designerGenes/cyclops/hardware/luckfox-pico-pro/SUPERSEDED.md

# SUPERSEDED — v0 "top-hood" enclosure

The `luckfox_enclosure_*` design generated by `enclosure_geometry.py` +
`generate_case.py` (and its `out/stl/` outputs) is **superseded**.

**Superseded by:** [`v1_1/src/luckfox_pill_enclosure.py`](v1_1/src/luckfox_pill_enclosure.py)
— the "fat pill" wall-camera enclosure, generator version 1.1. Read `v1_1/DESIGN.md`.

## What this directory now holds

| Path | Contents |
|---|---|
| `v0_superseded/` | The five pristine v0 STLs (`luckfox_enclosure_{base,cover,hood,gasket,thermal_seal}.stl`). Archived, never deleted. |
| `v1_1/` | The complete v1.1 set: `DESIGN.md`, `src/`, `stl/` (ASCII), `print/` (binary), `preview/`. |
| `enclosure_geometry.py`, `generate_case.py`, `generate.sh`, `tests/` | The v0 generator, **left in place, unedited**. |

## Why v0 was retired

Per `v1_1/DESIGN.md`: base and cover met in a flat butt joint with no screws,
clips, lip or overlap, so nothing held them together; the gasket groove left
0.2 mm side walls and bridged an open port; the hood pins did not retain; the
hood plate sat 8 mm in front of the camera aperture and blocked the field of
view; and there were no standoffs, camera mount or wall-mount features. The
replacement uses a screw closure, an O-ring cord seal, a printed board sled and
a wall bracket.

## Not to be confused with

- `print-submission/` — the earlier first-article print bundle for the **v0**
  design; it does not reflect v1.1.
- `out/` — v0 build artifacts; regenerate only if you intentionally revisit v0.
