designerGenes/cyclops/hardware/luckfox-pico-pro/out/preview/luckfox_enclosure_front.png

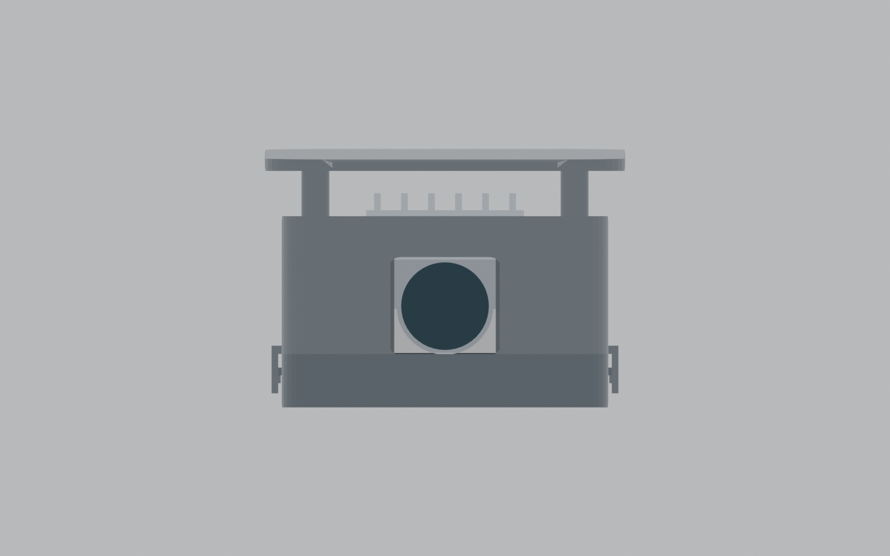
hardware/luckfox-pico-pro/out/preview/luckfox_enclosure_front.png
