designerGenes/cyclops/hardware/luckfox-pico-pro/out/preview/luckfox_enclosure_iso.png

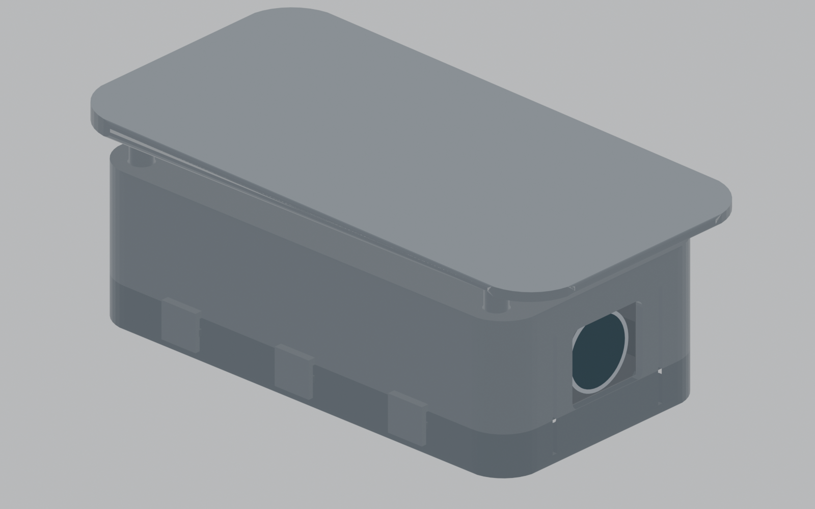
hardware/luckfox-pico-pro/out/preview/luckfox_enclosure_iso.png
