designerGenes/cyclops/hardware/luckfox-pico-pro/out/preview/luckfox_enclosure_rear.png

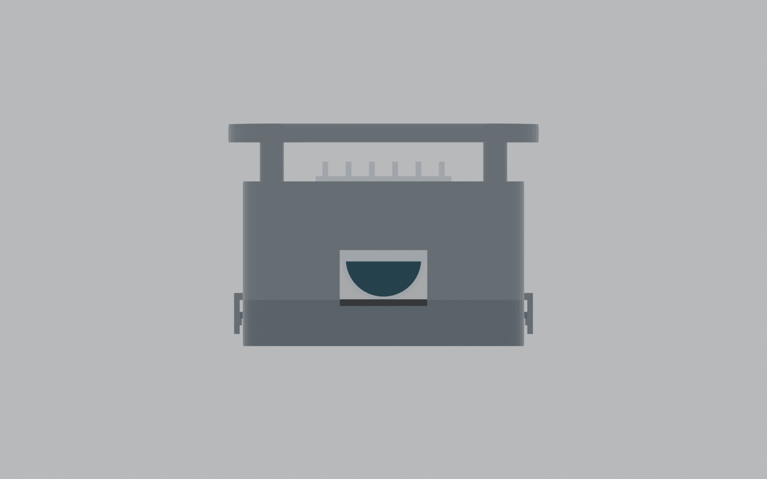
hardware/luckfox-pico-pro/out/preview/luckfox_enclosure_rear.png
