designerGenes/cyclops/hardware/luckfox-pico-pro/out/preview/luckfox_enclosure_side.png

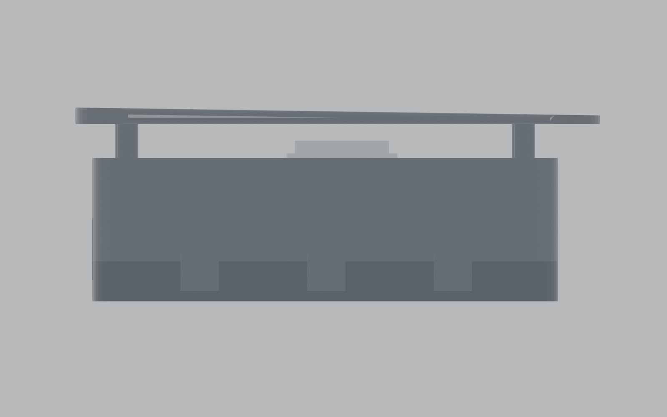
hardware/luckfox-pico-pro/out/preview/luckfox_enclosure_side.png
