designerGenes/cyclops/hardware/luckfox-pico-pro/out/preview/luckfox_enclosure_top.png

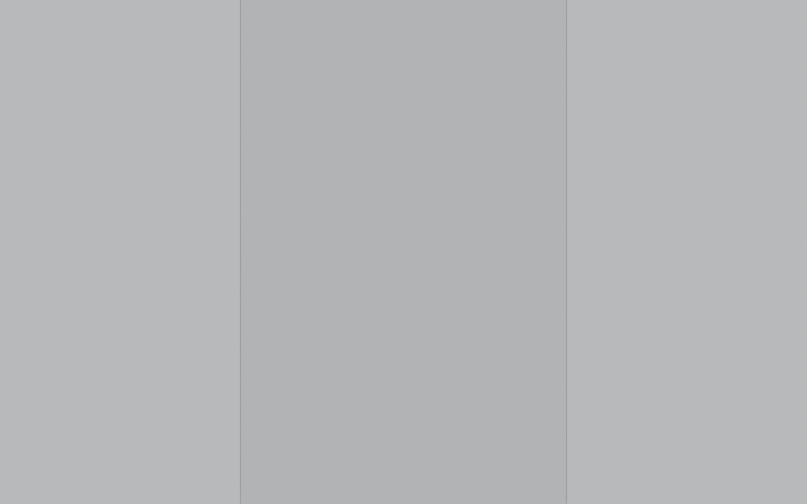
hardware/luckfox-pico-pro/out/preview/luckfox_enclosure_top.png
