designerGenes/cyclops/hardware/luckfox-pico-pro/v1_1/preview/assembly_preview_DO_NOT_PRINT.stl

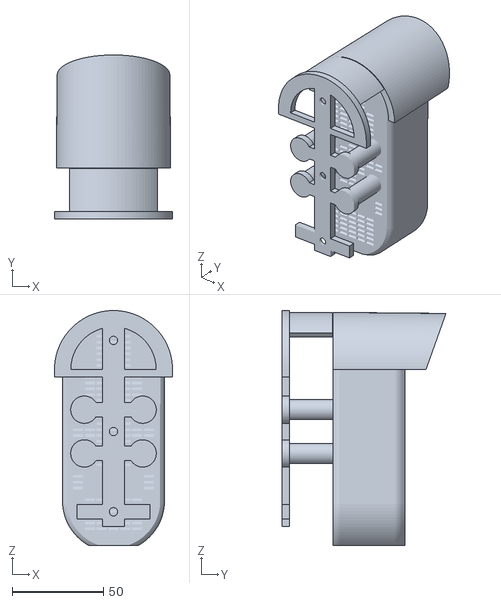
[picture p9: CAD file, 2026-10-25]
hardware/luckfox-pico-pro/v1_1/preview/assembly_preview_DO_NOT_PRINT.stl
64.8 x 90.0 x 128.9
