designerGenes/cyclops/hardware/luckfox-pico-pro/out/stl/luckfox_enclosure_thermal_seal.stl

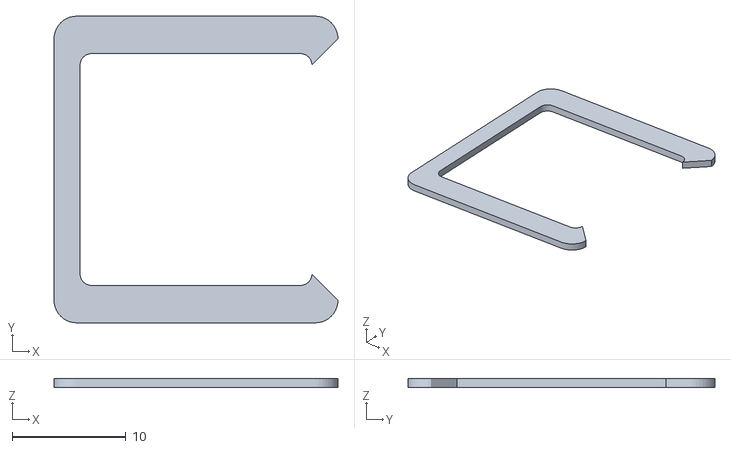
[picture p10: CAD file, 2026-10-25]
hardware/luckfox-pico-pro/out/stl/luckfox_enclosure_thermal_seal.stl
25.0 x 27.0 x 0.8
