designerGenes/cyclops/hardware/luckfox-pico-pro/v1_1/preview/board_sled.stl

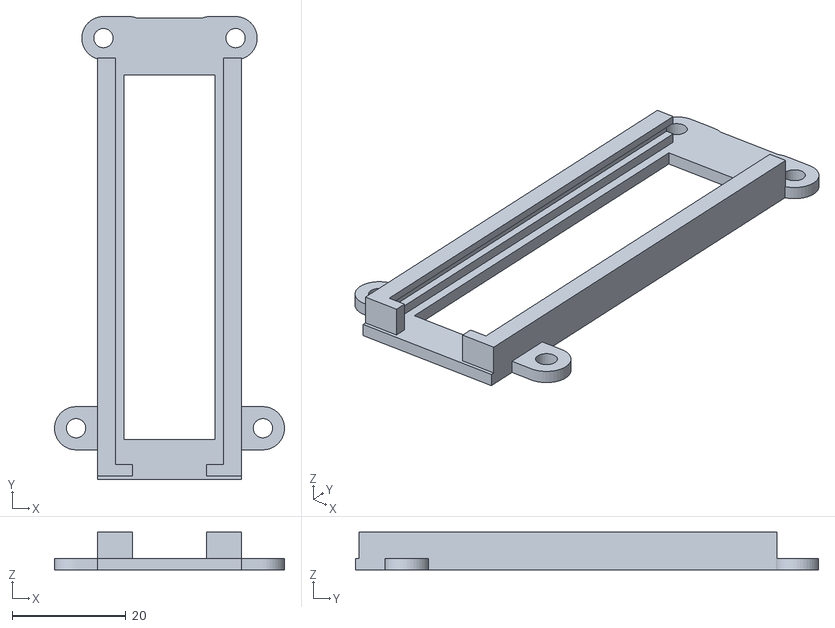
[picture p11: CAD file, 2026-10-25]
hardware/luckfox-pico-pro/v1_1/preview/board_sled.stl
40.4 x 81.3 x 6.60
