designerGenes/cyclops/hardware/luckfox-pico-pro/v1_1/print/wall_bracket.stl

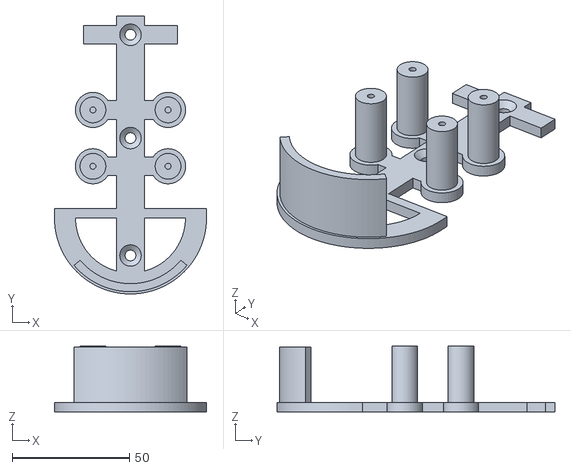
[picture p12: CAD file, 2026-10-25]
hardware/luckfox-pico-pro/v1_1/print/wall_bracket.stl
64.8 x 118.4 x 28.0
