designerGenes/cyclops/hardware/luckfox-pico-pro/out/stl/luckfox_enclosure_base.stl

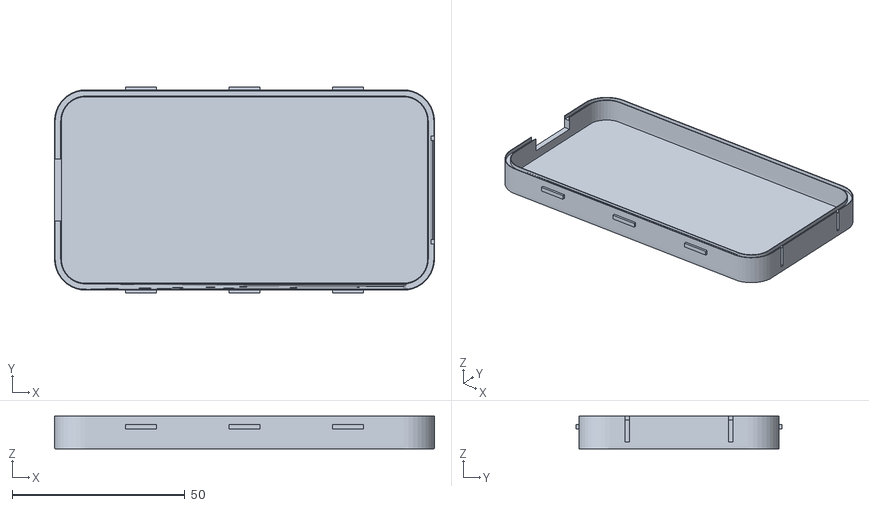
[picture p13: CAD file, 2026-10-25]
hardware/luckfox-pico-pro/out/stl/luckfox_enclosure_base.stl
110.0 x 59.6 x 9.50
