designerGenes/cyclops/hardware/luckfox-pico-pro/v1_1/preview/camera_clamp.stl

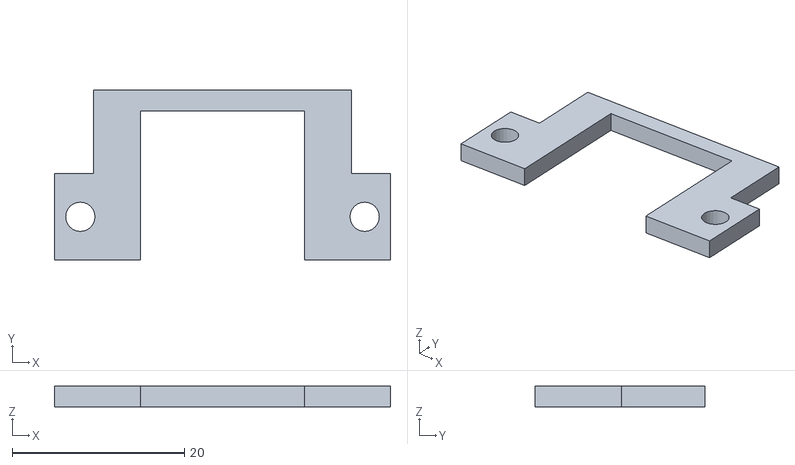
[picture p14: CAD file, 2026-10-25]
hardware/luckfox-pico-pro/v1_1/preview/camera_clamp.stl
39.0 x 19.7 x 2.40
