designerGenes/cyclops/hardware/luckfox-pico-pro/v1_1/print/pill_body.stl

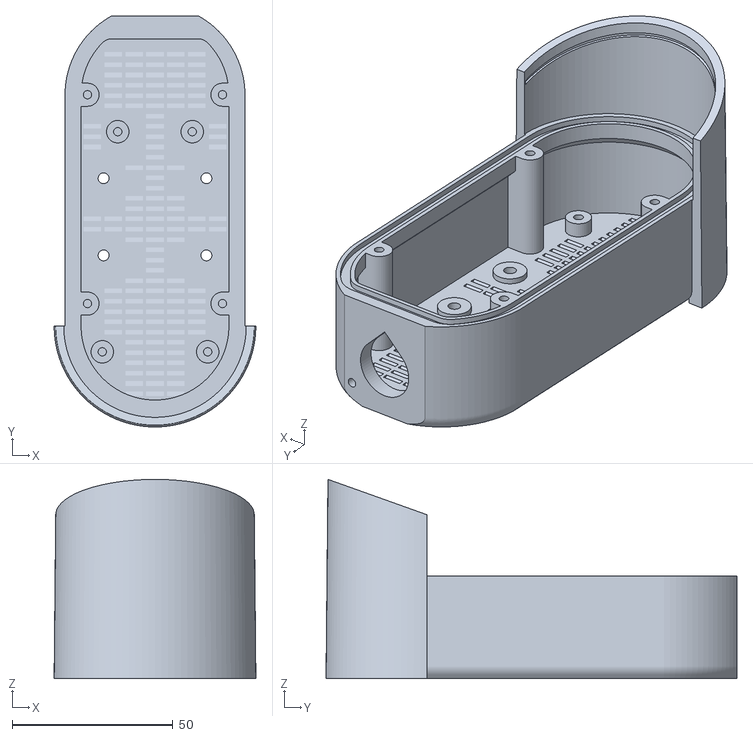
[picture p15: CAD file, 2026-10-25]
hardware/luckfox-pico-pro/v1_1/print/pill_body.stl
62.8 x 127.9 x 62.0
