designerGenes/cyclops/hardware/luckfox-pico-pro/out/stl/luckfox_enclosure_gasket.stl

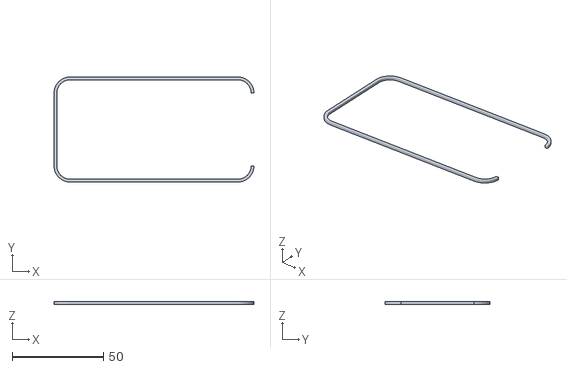
[picture p16: CAD file, 2026-10-25]
hardware/luckfox-pico-pro/out/stl/luckfox_enclosure_gasket.stl
109.6 x 57.6 x 1.40
