designerGenes/cyclops/hardware/luckfox-pico-pro/v1_1/print/pill_cover.stl

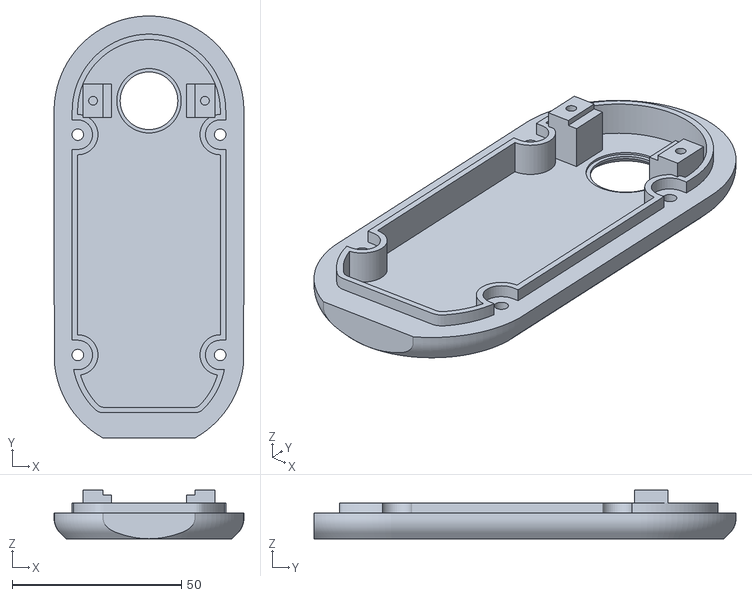
[picture p17: CAD file, 2026-10-25]
hardware/luckfox-pico-pro/v1_1/print/pill_cover.stl
56.0 x 124.5 x 14.4
