designerGenes/cyclops/hardware/luckfox-pico-pro/out/stl/luckfox_enclosure_cover.stl

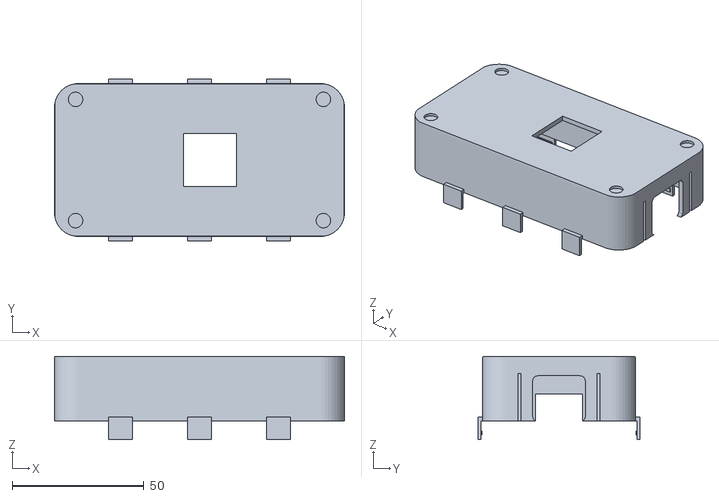
[picture p18: CAD file, 2026-10-25]
hardware/luckfox-pico-pro/out/stl/luckfox_enclosure_cover.stl
110.0 x 61.6 x 31.5
