designerGenes/cyclops/hardware/luckfox-pico-pro/out/stl/luckfox_enclosure_thermal_insert.stl

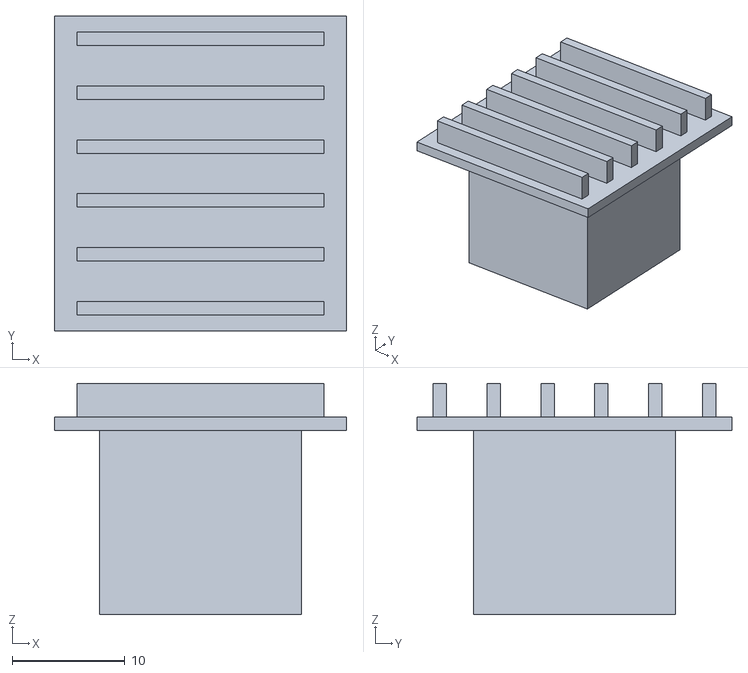
[picture p19: CAD file, 2026-10-04]
hardware/luckfox-pico-pro/out/stl/luckfox_enclosure_thermal_insert.stl
26.0 x 28.0 x 20.5
