designerGenes/cyclops/hardware/luckfox-pico-pro/out/stl/luckfox_enclosure_hood.stl

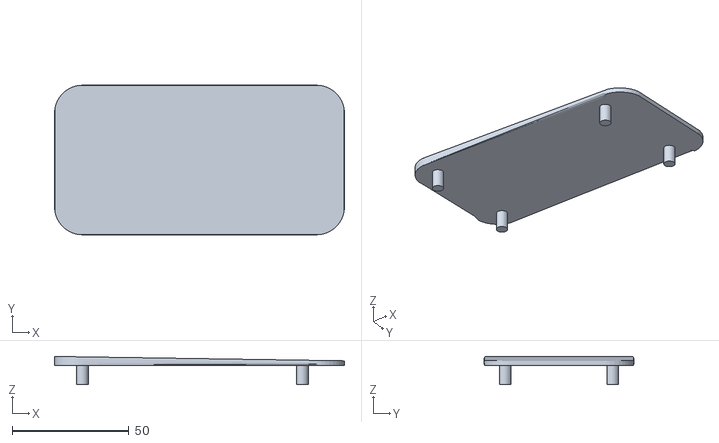
[picture p20: CAD file, 2026-10-04]
hardware/luckfox-pico-pro/out/stl/luckfox_enclosure_hood.stl
124.0 x 64.0 x 12.0
