designerGenes/cyclops/hardware/luckfox-pico-pro/out/stl/luckfox_enclosure_chimney.stl

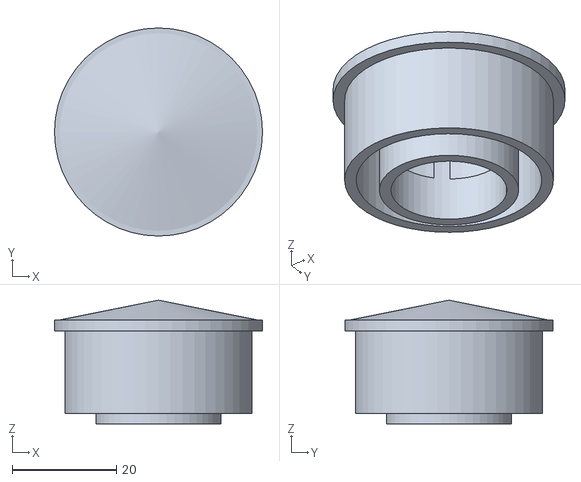
[picture p21: CAD file, 2026-10-03]
hardware/luckfox-pico-pro/out/stl/luckfox_enclosure_chimney.stl
40.0 x 40.0 x 23.8
