designerGenes/cyclops/hardware/luckfox-pico-pro/out/stl/luckfox_enclosure_nose.stl

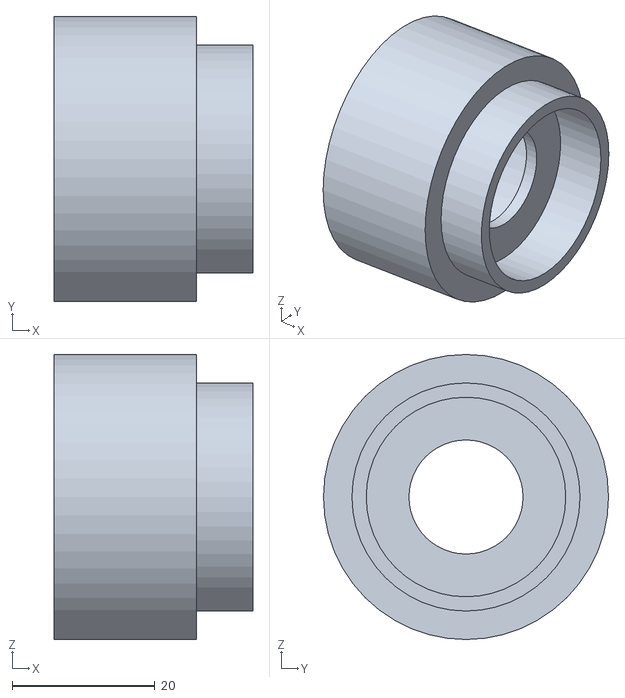
[picture p22: CAD file, 2026-10-03]
hardware/luckfox-pico-pro/out/stl/luckfox_enclosure_nose.stl
27.9 x 40.0 x 40.0
