designerGenes/cyclops/hardware/luckfox-pico-pro/v0_superseded/luckfox_enclosure_base.stl

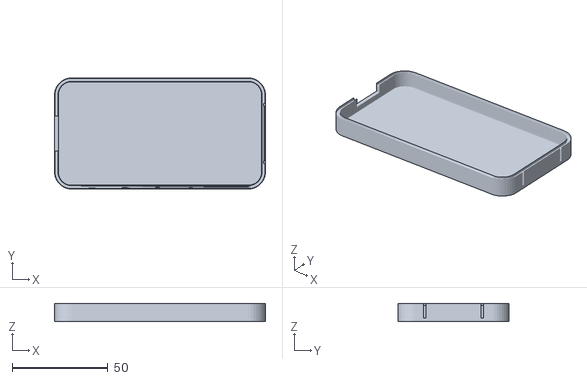
[picture p23: CAD file, 2026-10-25, an earlier design]
hardware/luckfox-pico-pro/v0_superseded/luckfox_enclosure_base.stl
110.0 x 58.0 x 9.50
