designerGenes/cyclops/(list of files, cad)

Other CAD files:
hardware/luckfox-pico-pro/print-submission/luckfox_enclosure_thermal_seal.stl
hardware/luckfox-pico-pro/v1_1/stl/board_sled.stl
hardware/luckfox-pico-pro/v1_1/stl/camera_clamp.stl
hardware/luckfox-pico-pro/out/luckfox_pico_pro_enclosure.blend
hardware/luckfox-pico-pro/v1_1/stl/pill_body.stl
hardware/luckfox-pico-pro/v1_1/stl/pill_cover.stl
hardware/luckfox-pico-pro/v1_1/stl/wall_bracket.stl
