designerGenes/cyclops/docs/testing/test-plan.md

# Test Plan

Cyclops Phase 1 verification requires all of the following. Run each command from the repository root.

## Python backend tests

```bash
uv run pytest apps/edge-camera/tests apps/coordinator-api/tests
```

Coverage includes edge MJPEG behavior, settings page/API, health reporting, coordinator registry loading, layout persistence, health polling, and stale layout reconciliation.

## Frontend unit tests

```bash
pnpm test
```

Coverage includes rendering 1/2/3/4/N camera layouts, offline tiles, reorder and resize state, localStorage persistence, and stale layout cleanup.

## Mobile end-to-end tests

```bash
pnpm --filter coordinator-web exec playwright test
```

The Playwright suite runs with a mobile viewport, verifies the stacked layout, tests tile reorder and resize behavior, confirms reload persistence, and ensures offline tiles remain visible.
