designerGenes/cyclops/firmware/luckfox-pico-pro/src/osd.c

/* On-device timestamp OSD for the Luckfox Cyclops eye.
 *
 * Draws "YYYY-MM-DD HH:MM:SS" into an ARGB8888 bitmap and overlays it on the
 * hardware H.264 encoder output via the Rockchip RGN module, so the timestamp
 * is burned into the stream (matching the Pi eyes' rpiCameraTextOverlay).
 *
 * The viewer applies a per-node display rotation (0/90/180/270 clockwise). To
 * keep the timestamp upright and in the top-left of what the viewer sees, the
 * text is rendered counter-rotated and attached to the corner of the sensor
 * frame that maps to the displayed top-left.
 *
 * Color: one of a few high-legibility presets (white/yellow/black/red), each
 * drawn with a contrasting outline (black under bright fills, white under the
 * black fill) so the digits stay crisp on any scene. The console advances the
 * preset on click; there is no automatic animation.
 * Size: an integer cell scale (3..12) controls the glyph size.
 */

#include "cyclops_eye/osd.h"

#include <pthread.h>
#include <stdatomic.h>
#include <stdbool.h>
#include <stdint.h>
#include <stdlib.h>
#include <string.h>
#include <time.h>
#include <unistd.h>

#include "rk_mpi_rgn.h"
#include "rk_common.h"

#define OSD_CHARS 19
#define OSD_OUTLINE_PX 2 /* outline thickness around the glyphs, in pixels */
#define OSD_RGN_HANDLE 0
#define OSD_MARGIN 16

/* The RV1106 rockit RGN overlay reads each ARGB8888 pixel as A(byte0),
 * R(byte1), G(byte2), B(byte3) in memory - i.e. the 32-bit value is
 * 0xBBGGRRAA with alpha in the LOW byte. Verified on hardware: packing as
 * 0xAARRGGBB put alpha in the ignored high byte, so any color whose low byte
 * was 0x00 vanished and channel order was wrong. OSD_RGB packs correctly. */
#define OSD_RGB(r, g, b) (((uint32_t)(b) << 24) | ((uint32_t)(g) << 16) | \
                          ((uint32_t)(r) << 8) | 0xFFu)

/* Legibility-first fill/outline pairs, indexed by the EYE_OSD_* presets. */
static const uint32_t OSD_FILL[EYE_OSD_COLOR_MAX + 1] = {
    OSD_RGB(0xFF, 0xFF, 0xFF), /* WHITE  */
    OSD_RGB(0xFF, 0xE4, 0x00), /* YELLOW */
    OSD_RGB(0x1A, 0x1A, 0x1A), /* BLACK  */
    OSD_RGB(0xFF, 0x3B, 0x30), /* RED    */
};
static const uint32_t OSD_OUTLINE[EYE_OSD_COLOR_MAX + 1] = {
    OSD_RGB(0x00, 0x00, 0x00), /* black outline for white */
    OSD_RGB(0x00, 0x00, 0x00), /* black outline for yellow */
    OSD_RGB(0xFF, 0xFF, 0xFF), /* white outline for black */
    OSD_RGB(0x00, 0x00, 0x00), /* black outline for red */
};

/* Each row is 3 bits, bit0 = leftmost column. */
static const unsigned char FONT3X5[13][5] = {
    {7, 5, 5, 5, 7}, /* 0 */
    {2, 6, 2, 2, 7}, /* 1 */
    {7, 1, 7, 4, 7}, /* 2 */
    {7, 1, 7, 1, 7}, /* 3 */
    {5, 5, 7, 1, 1}, /* 4 */
    {7, 4, 7, 1, 7}, /* 5 */
    {7, 4, 7, 5, 7}, /* 6 */
    {7, 1, 1, 1, 1}, /* 7 */
    {7, 5, 7, 5, 7}, /* 8 */
    {7, 5, 7, 1, 7}, /* 9 */
    {0, 0, 7, 0, 0}, /* - */
    {0, 2, 0, 2, 0}, /* : */
    {0, 0, 0, 0, 0}, /* space (anything else) */
};

static int glyph_index(char c) {
    if (c >= '0' && c <= '9') return c - '0';
    if (c == '-') return 10;
    if (c == ':') return 11;
    return 12;
}

struct eye_osd {
    RGN_HANDLE handle;
    int venc_channel;
    int frame_w;
    int frame_h;
    int rotation;   /* 0/90/180/270 clockwise, as the viewer rotates */
    int scale;      /* glyph cell size in pixels */
    int color;      /* EYE_OSD_* preset */
    int text_w;     /* rendered text bitmap size */
    int text_h;
    int dst_w;      /* rendered bitmap size after counter-rotation */
    int dst_h;
    uint32_t *text; /* horizontal text, text_w x text_h */
    uint32_t *buf;  /* counter-rotated bitmap attached to the VENC */
    pthread_t thread;
    atomic_bool running;
    atomic_bool update_pending; /* set by eye_osd_set_color to force a refresh */
    bool started;
};

/* Paint a solid block into `buf`, clamped to [0,text_w) x [0,text_h). */
static void paint_block(eye_osd_t *o, int x, int y, int w, int h, uint32_t color) {
    if (x < 0) { w += x; x = 0; }
    if (y < 0) { h += y; y = 0; }
    if (x + w > o->text_w) w = o->text_w - x;
    if (y + h > o->text_h) h = o->text_h - y;
    if (w <= 0 || h <= 0) return;
    for (int dy = 0; dy < h; dy++) {
        uint32_t *line = o->text + (size_t)(y + dy) * o->text_w + x;
        for (int dx = 0; dx < w; dx++) line[dx] = color;
    }
}

static uint32_t osd_fill_color(const eye_osd_t *o) {
    return OSD_FILL[o->color];
}

static void render_text(eye_osd_t *o, const char *s, uint32_t fill, uint32_t outline) {
    memset(o->text, 0, (size_t)o->text_w * o->text_h * sizeof(uint32_t));
    int scale = o->scale;
    int x0 = 0;
    /* Pass 1: draw the outline (a dilation of the glyph) for every lit cell
     * first, so adjacent cells merge into one contiguous border instead of
     * black streaks cutting through the fill. */
    for (int i = 0; s[i] != '\0' && i < OSD_CHARS; i++, x0 += 4 * scale) {
        int gi = glyph_index(s[i]);
        for (int row = 0; row < 5; row++) {
            unsigned bits = FONT3X5[gi][row];
            for (int col = 0; col < 3; col++) {
                if (!((bits >> col) & 1u)) continue;
                /* Glyph table encodes bit0 as the RIGHTMOST column, so reverse
                 * the column order here. */
                int px = x0 + (2 - col) * scale;
                int py = row * scale;
                paint_block(o, px - OSD_OUTLINE_PX, py - OSD_OUTLINE_PX,
                            scale + 2 * OSD_OUTLINE_PX, scale + 2 * OSD_OUTLINE_PX, outline);
            }
        }
    }
    /* Pass 2: the colored fill, painted last so it is never overwritten. */
    x0 = 0;
    for (int i = 0; s[i] != '\0' && i < OSD_CHARS; i++, x0 += 4 * scale) {
        int gi = glyph_index(s[i]);
        for (int row = 0; row < 5; row++) {
            unsigned bits = FONT3X5[gi][row];
            for (int col = 0; col < 3; col++) {
                if (!((bits >> col) & 1u)) continue;
                int px = x0 + (2 - col) * scale;
                int py = row * scale;
                paint_block(o, px, py, scale, scale, fill);
            }
        }
    }
}

/* Rotate src (sw x sh) clockwise by deg (0/90/180/270) into dst, returning the
 * output dimensions. */
static void rotate_cw(const uint32_t *src, int sw, int sh,
                      uint32_t *dst, int deg, int *dw, int *dh) {
    if (deg == 90 || deg == 270) { *dw = sh; *dh = sw; }
    else { *dw = sw; *dh = sh; }
    for (int y = 0; y < *dh; y++) {
        for (int x = 0; x < *dw; x++) {
            int sx, sy;
            if (deg == 90)       { sx = y;          sy = sh - 1 - x; }
            else if (deg == 180) { sx = sw - 1 - x; sy = sh - 1 - y; }
            else if (deg == 270) { sx = sw - 1 - y; sy = x; }
            else                 { sx = x;          sy = y; }
            dst[(size_t)y * (*dw) + x] = src[(size_t)sy * sw + sx];
        }
    }
}

static void osd_render(eye_osd_t *o, const char *s) {
    render_text(o, s, osd_fill_color(o), OSD_OUTLINE[o->color]);
    /* Counter-rotate the text by the viewer's rotation. */
    int deg = (360 - o->rotation) % 360;
    rotate_cw(o->text, o->text_w, o->text_h, o->buf, deg, &o->dst_w, &o->dst_h);
}

static void osd_position(const eye_osd_t *o, int *x, int *y) {
    switch (o->rotation) {
    case 90:
        *x = OSD_MARGIN;
        *y = o->frame_h - o->dst_h - OSD_MARGIN;
        break;
    case 180:
        *x = o->frame_w - o->dst_w - OSD_MARGIN;
        *y = o->frame_h - o->dst_h - OSD_MARGIN;
        break;
    case 270:
        *x = o->frame_w - o->dst_w - OSD_MARGIN;
        *y = OSD_MARGIN;
        break;
    default:
        *x = OSD_MARGIN;
        *y = OSD_MARGIN;
        break;
    }
}

static void osd_chn(MPP_CHN_S *chn, int venc_channel) {
    memset(chn, 0, sizeof(*chn));
    chn->enModId = RK_ID_VENC;
    chn->s32DevId = 0;
    chn->s32ChnId = venc_channel;
}

static void osd_push(eye_osd_t *o) {
    BITMAP_S bmp;
    memset(&bmp, 0, sizeof(bmp));
    bmp.enPixelFormat = RK_FMT_ARGB8888;
    bmp.u32Width = (RK_U32)o->dst_w;
    bmp.u32Height = (RK_U32)o->dst_h;
    bmp.pData = o->buf;
    (void)RK_MPI_RGN_SetBitMap(o->handle, &bmp);
}

static void *osd_thread(void *arg) {
    eye_osd_t *o = arg;
    time_t last = 0;
    while (atomic_load(&o->running)) {
        time_t now = time(NULL);
        bool forced = atomic_exchange(&o->update_pending, false);
        if (!forced && now == last) {
            usleep(100000); /* 100ms wake; re-render on the next second or update */
            continue;
        }
        last = now;
        struct tm tm;
        localtime_r(&now, &tm);
        char s[32];
        if (strftime(s, sizeof(s), "%Y-%m-%d %H:%M:%S", &tm) > 0) {
            osd_render(o, s);
            osd_push(o);
        }
    }
    return NULL;
}

static int osd_attach(eye_osd_t *o) {
    RGN_ATTR_S attr;
    memset(&attr, 0, sizeof(attr));
    attr.enType = OVERLAY_RGN;
    attr.unAttr.stOverlay.enPixelFmt = RK_FMT_ARGB8888;
    attr.unAttr.stOverlay.stSize.u32Width = (RK_U32)o->dst_w;
    attr.unAttr.stOverlay.stSize.u32Height = (RK_U32)o->dst_h;
    attr.unAttr.stOverlay.u32CanvasNum = 2;
    if (RK_MPI_RGN_Create(o->handle, &attr) != RK_SUCCESS) return -1;
    osd_push(o);

    MPP_CHN_S chn;
    osd_chn(&chn, o->venc_channel);
    int x, y;
    osd_position(o, &x, &y);
    RGN_CHN_ATTR_S ca;
    memset(&ca, 0, sizeof(ca));
    ca.bShow = RK_TRUE;
    ca.enType = OVERLAY_RGN;
    ca.unChnAttr.stOverlayChn.stPoint.s32X = x;
    ca.unChnAttr.stOverlayChn.stPoint.s32Y = y;
    ca.unChnAttr.stOverlayChn.u32FgAlpha = 255;
    ca.unChnAttr.stOverlayChn.u32BgAlpha = 0;
    ca.unChnAttr.stOverlayChn.u32Layer = 0;
    if (RK_MPI_RGN_AttachToChn(o->handle, &chn, &ca) != RK_SUCCESS) {
        (void)RK_MPI_RGN_Destroy(o->handle);
        return -1;
    }
    return 0;
}

eye_osd_t *eye_osd_start(int venc_channel, int frame_w, int frame_h,
                         int rotation, int scale, int color) {
    eye_osd_t *o = calloc(1, sizeof(*o));
    if (o == NULL) return NULL;
    atomic_store(&o->update_pending, false);
    o->venc_channel = venc_channel;
    o->frame_w = frame_w;
    o->frame_h = frame_h;
    rotation = ((rotation % 360) + 360) % 360;
    o->rotation = (rotation / 90) * 90;   /* snap to 0/90/180/270 */
    if (scale < 3) scale = 3;
    if (scale > 12) scale = 12;
    o->scale = scale;
    if (color < EYE_OSD_WHITE) color = EYE_OSD_WHITE;
    if (color > EYE_OSD_COLOR_MAX) color = EYE_OSD_COLOR_MAX;
    o->color = color;
    o->text_w = ((OSD_CHARS * 4 * scale) + 15) / 16 * 16;   /* align 16 */
    o->text_h = ((5 * scale) + 15) / 16 * 16;               /* align 16 */
    o->handle = OSD_RGN_HANDLE;
    o->text = calloc((size_t)o->text_w * o->text_h, sizeof(uint32_t));
    o->buf = calloc((size_t)o->text_w * o->text_h, sizeof(uint32_t));
    if (o->text == NULL || o->buf == NULL) {
        free(o->text); free(o->buf); free(o);
        return NULL;
    }
    osd_render(o, "0000-00-00 00:00:00");
    if (osd_attach(o) != 0) {
        free(o->text); free(o->buf); free(o);
        return NULL;
    }

    atomic_store(&o->running, true);
    if (pthread_create(&o->thread, NULL, osd_thread, o) != 0) {
        atomic_store(&o->running, false);
        MPP_CHN_S chn;
        osd_chn(&chn, o->venc_channel);
        (void)RK_MPI_RGN_DetachFromChn(o->handle, &chn);
        (void)RK_MPI_RGN_Destroy(o->handle);
        free(o->text); free(o->buf); free(o);
        return NULL;
    }
    o->started = true;
    return o;
}

void eye_osd_set_color(eye_osd_t *o, int color) {
    if (o == NULL) return;
    if (color < EYE_OSD_WHITE) color = EYE_OSD_WHITE;
    if (color > EYE_OSD_COLOR_MAX) color = EYE_OSD_COLOR_MAX;
    if (color == o->color) return;
    o->color = color;
    atomic_store(&o->update_pending, true);
}

void eye_osd_stop(eye_osd_t *o) {
    if (o == NULL) return;
    if (o->started) {
        atomic_store(&o->running, false);
        (void)pthread_join(o->thread, NULL);
    }
    MPP_CHN_S chn;
    osd_chn(&chn, o->venc_channel);
    (void)RK_MPI_RGN_DetachFromChn(o->handle, &chn);
    (void)RK_MPI_RGN_Destroy(o->handle);
    free(o->text);
    free(o->buf);
    free(o);
}
