designerGenes/cyclops/deployed/eyes/camera-01/boot-firmware/config.txt

# For more options and information see
# http://rptl.io/configtxt
# Some settings may impact device functionality. See link above for details

# Uncomment some or all of these to enable the optional hardware interfaces
dtparam=i2c_arm=on
#dtparam=i2s=on
#dtparam=spi=on

# Enable audio (loads snd_bcm2835)
dtparam=audio=on

# Additional overlays and parameters are documented
# /boot/firmware/overlays/README

# Automatically load overlays for detected cameras
camera_auto_detect=1
dtoverlay=imx708
start_x=1
gpu_mem=128

# Automatically load overlays for detected DSI displays
display_auto_detect=1

# Automatically load initramfs files, if found
auto_initramfs=1

# Enable DRM VC4 V3D driver
dtoverlay=vc4-kms-v3d
max_framebuffers=2

# Don't have the firmware create an initial video= setting in cmdline.txt.
# Use the kernel's default instead.
disable_fw_kms_setup=1

# Run in 64-bit mode
arm_64bit=1

# Disable compensation for displays with overscan
disable_overscan=1

# Run as fast as firmware / board allows
arm_boost=1

start_x=1
gpu_mem=128

[cm4]
# Enable host mode on the 2711 built-in XHCI USB controller.
# This line should be removed if the legacy DWC2 controller is required
# (e.g. for USB device mode) or if USB support is not required.
otg_mode=1

[cm5]
dtoverlay=dwc2,dr_mode=host

[all]

# ---- BEGIN under-clock block ----
arm_freq=800
arm_freq_min=400
core_freq=300
gpu_freq=300
over_voltage=-2
force_turbo=0
# ----  END under-clock block  ----

# Performance tuning settings
arm_freq=800
core_freq=250
sdram_freq=400
over_voltage=-2

# Thermal throttling soft/hard limits (in deg C)
temp_soft_limit=60
temp_limit=70

# Force throttling instead of shutdown
avoid_warnings=1
dtparam=watchdog=on
dtoverlay=disable-bt
