designerGenes/cyclops/(commit log)

2026-08-29 Snapshot deployed Cyclops system (coordinator brain + camera-01/camera-02 eyes)
    Exact copies of the running software captured 2026-08-28 after the
    camnode tier-drift fix. Includes brain /opt/cyclops source, central
    mediamtx config, systemd units, eye camnode agent, node configs, and
    per-eye boot firmware. Enrollment token redacted; venvs, binaries,
    model weights, logs, and alert images excluded. See deployed/README.md.
2026-08-29 Governor clamp: manual tier/fps overrides can no longer exceed thermal budget
    Both eyes overheated again after tier/fps overrides were set from the
    stream UI (camera-01 pinned at warm, camera-02 boosted to 12fps on a
    critical node). The governor now: always runs thermal logic even under
    override; an override can only make the camera run cooler than the
    thermal policy requires; fps boosts are suspended automatically at
    hot/critical. Heartbeat/health now report the effective tier.
2026-08-29 Software heat reductions: LAN-direct RTSP, detect 4fps cap, MoQ off, thermal SMS alert
    Eyes were burning 27-40% CPU in tailscaled encrypting the brain's RTSP
    pull, plus wasted MJPEG frames. Changes:
    - camnode agent reports its LAN IPv4 (register + heartbeat)
    - brain registry stores lan_host; RTSP endpoints prefer the LAN route,
    switching proxy + detect watcher when learned; tailnet fallback after
    3 failed readiness checks, LAN retry every 10 min
    - detect stream capped at 4 fps (brain samples at 4; the rest was heat)
    - mediamtx.yml.j2 + node ymls: moq off, cdn_fast, tier-realistic params
    - brain thermal watchdog: SMS via existing Twilio channel when a node
    holds critical tier for 10+ mi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
2026-10-03 Add LuckFox Pico Pro Eye firmware
2026-10-03 Add weatherproof LuckFox Pico Pro enclosure (passive chimney, Blender parametric)
2026-10-03 Round the LuckFox enclosure: capsule body, round chimney, lens barrel, beveled edges
2026-10-04 Redesign LuckFox enclosure with recessed optics and top hood
2026-10-05 Luckfox RV1106 eye: real camera path, SDK integration, and runbook
    Firmware:
    - initialize Rockchip AIQ/ISP before VI/VENC; use /oem/usr/share/iqfiles
    - redesign: single camera owner via RkLunch.sh (cyclops-eye, rkipc fallback)
    - re-discover the LAN IP every heartbeat (this board's DHCP address changes
    per boot) so the coordinator keeps a working LAN RTSP route
    SDK integration (firmware/luckfox-pico-pro/sdk-integration):
    - app-Makefile: cross-compile cyclops-eye against media libs
    - RkLunch.sh: robust camera-owner launcher
    - make-image.sh / provision-eye.sh / RUNBOOK.md / watch-build.sh
    Validated end-to-end on a Pico Pro/Max: cyclops-eye auto-starts, serves
    /cam (H.264 1920x1080) and /det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
2026-10-06 hardware(luckfox): bundle first-article print service print submission
    - Add hardware/luckfox-pico-pro/print-submission/: one enclosure set
    (base, cover, hood, gasket, thermal_seal) with README covering part
    list, ABS-only material caveats, and cost estimate for the City of
    print service Library 3D printing service.
    - Remove obsolete chimney/nose STLs (no longer emitted by the generator).
    - Point the hardware README at the submission bundle.
2026-10-09 firmware(luckfox): harden camera-owner lifecycle against librkaiq teardown crash
    Root cause: cyclops-eye SIGSEGVs inside librkaiq.so (rk_aiq_uapi2_sysctl_stop/
    deinit) every time it tears the ISP pipeline down, and the same teardown can
    strand the ISP/MPP kthreads in D state (board looks offline until power-cycled).
    All five core-*-cyclops-eye dumps fault at librkaiq.so+0x52f08 with r0=0.
    - RkLunch-stop.sh: hard-kill cyclops-eye (SIGKILL) on stop so the buggy rk_aiq
    teardown never runs during shutdown. Verified: reboot now produces no core.
    - RkLunch.sh: supervisor restarts the camera owner if it dies, and reboots the
    board after 5 consecutive fast failures (self-heal from a wedged medi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
2026-10-09 firmware(luckfox): only reconfigure the camera on a real tier/fps change
    eye_camera_apply_tier() tears down and rebuilds the whole MPP VI/VENC pipeline.
    A redundant control command or a no-op governor step previously rebuilt it
    anyway, and every teardown is a chance for the RK ISP/VENC driver to wedge
    (stop_streaming leaving buf in active state -> frozen userspace). Track the
    applied tier/fps and only reconfigure when it actually changes.
2026-10-09 firmware(luckfox): burn a timestamp OSD into the eye's video
    The Luckfox eye had no on-video timestamp (the Pi eyes get one from MediaMTX's
    rpiCameraTextOverlay). Add an on-device equivalent using the Rockchip RGN
    overlay module: a 3x5 bitmap font rendered to ARGB8888 and attached to the
    primary VENC channel, refreshed once per second from local time.
    - src/osd.c, include/cyclops_eye/osd.h: the overlay + refresh thread.
    - camera_rv1106.c: create it on stream start, destroy it before teardown
    (so it survives tier reconfigs).
    - Uses /etc/TZ (POSIX 'CST6CDT,M3.2.0,M11.1.0') for local time; the board eyes
    have no tzdata.
2026-10-09 firmware(luckfox): fix OSD glyph mirroring and orientation
    The glyph table encodes bit0 as the rightmost column, but render() mapped
    bit0 to the leftmost column, so every digit was horizontally mirrored; the
    earlier 'vertical flip' then produced a 180-degree rotation. Reverse the
    column mapping and drop the flip (the RGN draws the bitmap as-is). Verified
    on device: 2026-10-09 03:48:54 renders upright.
2026-10-09 firmware(luckfox): resilience + bake TZ/init into the image
    - RkLunch.sh: export TZ (local-time OSD without tzdata) and drop the
    supervisor's reboot logic - the hardware watchdog now owns recovery, so a
    missing camera just retries instead of reboot-looping.
    - make-image.sh: stage /etc/TZ + /etc/init.d/S98tailscale into the rootfs via
    the overlay-luckfox-config overlay.
    - RUNBOOK: new section 10 (watchdog, the './build.sh firmware does not rebuild
    the kernel' gotcha, the no-camera rc=139 crash, reflash re-provisioning).
2026-10-10 firmware(luckfox): ignore SIGPIPE so a client disconnect cannot kill the daemon
    cyclops-eye was dying rc=141 (SIGPIPE) whenever the brain's RTSP reader
    disconnected mid-frame, then the supervisor restarted it -> the stream
    flickered and the brain reported 'source no signal'. SIG_IGN makes writes to a
    closed socket return EPIPE instead of killing the process. Verified: daphne
    ran ~5 min with zero deaths (was dying every ~127 s).
2026-10-10 docs(luckfox): RUNBOOK entry for rc=141 SIGPIPE stream 'flicker'
    Adds a troubleshooting row and a resilience gotcha explaining that a
    'source no signal' flicker with 'exited rc=141' in the supervisor log is the
    daemon being killed by SIGPIPE on a closed RTSP client socket, not a board
    reset. Includes how to tell it apart from a watchdog reset.
2026-10-17 feat(cyclops): more sensitive presence detection + grid/list feed layout
    - detector: sliding-window confirmation (min_hits in hit_window_s) instead of
    consecutive frames, 8 fps sampling, 0.30 score threshold, 60 s presence
    latch, and a detections.jsonl log for tuning.
    - eyes: /detect stream bitrate 250 -> 800 kbps (8 fps cap) so the Hailo
    YOLOv8m sees far less compression blur.
    - UI: grid/list toggle (persisted in localStorage) with a responsive
    auto-fit tile grid; list remains the default.
2026-10-18 feat(eye,ui): rotate the timestamp OSD with the feed's display rotation
    The timestamp is burned into the video, so a viewer-side rotation also spun the
    text. The eye now renders the OSD counter-rotated and attaches it to the corner
    that maps to the displayed top-left, for 0/90/180/270. The rotation is a new
    eye config key (rotation=), and the brain's rotation API forwards changes to the
    eye's control server so it applies immediately. Verified daphne (0) and
    martincrane (180) via captured frames.
2026-10-18 feat(alerts): deliver presence alerts via ntfy; add live detection probe
    The [ntfy] config was never parsed and alerts only ever tried Twilio (which is
    not configured), so nothing reached a phone. Add NtfyCfg parsing, fan alerts out
    to ntfy + Twilio independently, and add GET /api/debug/detect/{name} to run the
    detector against the latest frame from an eye for live diagnosis.
2026-10-18 fix(detect): parse the Hailo NMS output as (classes, 5, N)
    The HEF returns (80, 5, 100): axis 0 of the class block is
    [ymin,xmin,ymax,xmax,score] and axis 1 is the detection index. The code
    reshaped row-major, so every real box became [ymin,0,0,0,score=0] and was
    dropped; the rare alerts were accidental false positives. Normalise the batch
    dim, pick the person class, and transpose when the layout is (5,N).
    Before: 0 boxes on a clearly visible person. After: 0.915-0.919 on daphne,
    logged to detections.jsonl and alerted. Also adds /api/debug/frame/{name} and
    a threshold= override on /api/debug/detect/{name}.
2026-10-18 feat(alerts): attach the detection snapshot to the ntfy notification
    The alert body linked to http://cyclops:8080, a LAN-only hostname a phone cannot
    resolve. Upload the JPEG to ntfy instead (PUT + Filename header) so it is shown
    inline, and drop the dead link from the body. Verified: attachment name
    20261018-174306_camera-02.jpg with a public ntfy file URL.
2026-10-18 feat(ui,api): per-camera presence-alert mute
    Adds Node.notify (persisted), POST /api/nodes/{name}/notify, and an
    alerts / alerts off toggle in each tile. Detection still updates the presence
    badge and detections.jsonl; only the phone notification is suppressed.
2026-10-22 fix(alerts): rotate the detection snapshot with the camera's display rotation
    martincrane is mounted 180, so its alert snapshots were upside down even though
    the live view is corrected. Draw the box first, then rotate the annotated frame
    to match the viewer.
2026-10-25 feat: release Cyclops firmware and enclosure updates
2026-10-31 fix(ui): pre-rotate camera streams so native PiP honors display rotation
2026-10-31 fix(firmware): gate eye wire frame rate to target fps
    All eyes were publishing both streams at sensor-native ~30fps (the VI frame
    rate cap was ignored), and the single-core SoC dropped RTP frames in bursts,
    making feeds choppy. Add a wall-clock gate in the VENC->RTSP tx loop that
    caps the published rate to the tier fps (15 primary / 8 detect), independent
    of SDK frame-rate behavior. Forcing s32SrcFrameRate instead stalls the
    Rockit VI converter on RV1106, so src stays at -1.
2026-10-31 feat: per-eye timestamp OSD color/size settings
    Add per-eye controls for the burned-in timestamp overlay:
    - firmware: new osd_scale (3..12) and osd_color (white/cycle/yellow/cyan/
    magenta/orange/green) config keys; the OSD renderer now draws each glyph
    with a black outline for contrast and can cycle the fill through a palette
    of saturated hues once per second; POST /osd control endpoint applies
    changes live and writes them back to the config file so they survive reboot
    - coordinator: registry persists per-node osd scale/color; /api/nodes/{name}/osd
    forwards to the eye; node list exposes the values
    - console: per-tile timestamp color selector and size +/- buttons
    Also fix the stale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
2026-10-31 fix(firmware): correct OSD color byte order + instant color updates
    The RV1106 rockit RGN reads its 'ARGB8888' bitmap as A,R,G,B in memory
    (32-bit value 0xBBGGRRAA, alpha in the low byte). Packing as 0xAARRGGBB
    left alpha in the ignored high byte, so any color whose low byte was 0x00
    rendered fully transparent and the channel order was swapped. Verified on
    hardware: yellow now renders as (255,218,0), previously showed as cyan.
    Also make color-only changes apply in place (eye_osd_set_color sets a pending
    flag; the OSD thread wakes every 100ms and re-renders immediately) instead of
    doing a full region teardown, and keep the 1s-per-second refresh.
2026-10-31 fix(firmware): sync clock before first frame so timestamps never step
    Each boot seeds the clock from an RTC that is initialized only once, so the
    running 'ntpd -g' STEPS the clock a few seconds after startup - visibly
    bouncing the burned-in timestamp forward/backward during the first minute.
    Add a small one-shot NTP client (ntp_sync.c) and run it, best-effort and
    bounded, before the camera pipeline starts. The daemon then finds ~zero
    offset and never steps. Verified on daphnemoon: clock correct at camera-up
    (uptime 25s) vs the host clock.
2026-10-31 fix: revert broken frame-drop gate; 720p + larger encode buffer; legible OSD
    - Revert the wall-clock frame-drop 'fps gate': dropping H.264 frames at the
    network layer corrupted reference frames (motion ghosting artifacts) and
    made the stream's timing variable enough to destroy MediaMTX's HLS muxer
    ('too many reordered frames'), breaking iOS playback.
    - To address the original overload that caused choppiness and iOS dropout,
    encode the primary stream at 1280x720/1.5Mbps and double the VENC stream
    buffer count (3->6), so frame delivery stays clean without dropping frames.
    - Redesign the timestamp OSD: two-pass render (outline drawn before fill) so
    digits are crisp instead of garble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
2026-10-31 fix(web): rotate via CSS on iOS instead of canvas pipeline
    iOS Safari can't reliably play a canvas.captureStream() fed by native HLS,
    so rotated cameras (martincrane's 180) rendered a blank tile on iPhone/iPad
    while rotation-0 cameras worked. Route iOS to the CSS transform branch for
    inline rotation; keep the canvas pipeline for desktop where native PiP
    requires pre-rotated frames.
